XLC-WyldFyre/Robocup-Junior-2026/(list of files, cad)

Other CAD files:
PCBs/Bottom_PCB.f3z
PCBs/Top_PCB.f3z
