XLC-WyldFyre/Robocup-Junior-2026/PCBs/Top_PCB.brd

## EAGLE design PCBs/Top_PCB.brd (2026-08-17)

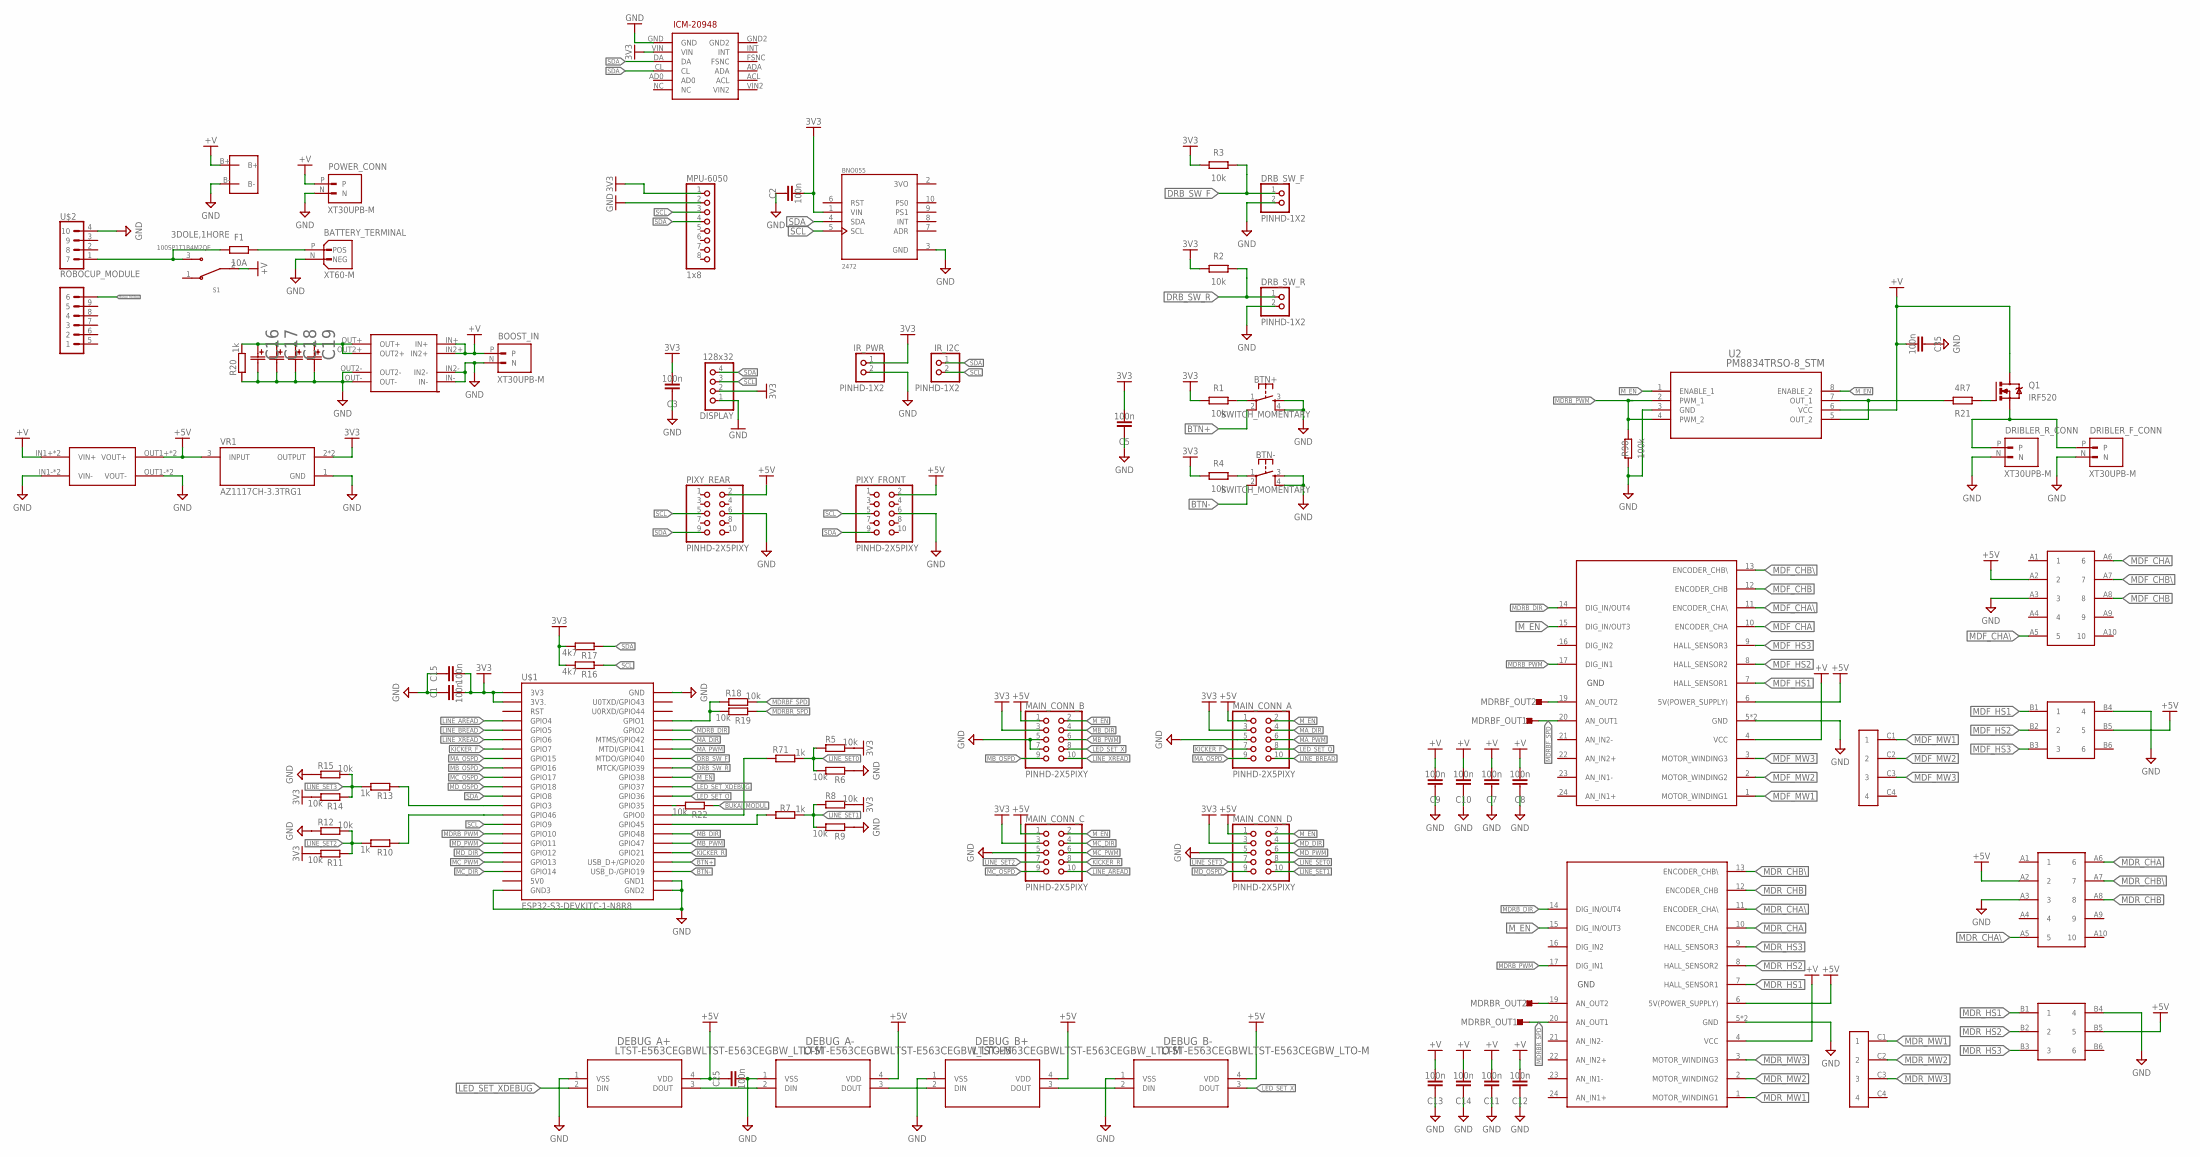
[picture p1: schematic Top_PCB.sch]

Parts:
BATTERY_TERMINAL: XT60-M; AMASS_XT60-M
BATT_VOLTAGE: BATT_V_METER; 1X02
BNO055: 2472; MODULE_2472
BOOST_IN: XT30UPB-M; AMASS_XT30UPB-M
BTN+: SWITCH_MOMENTARY; SWITCH-MOMENTARY-PTH-6.5MM
BTN-: SWITCH_MOMENTARY; SWITCH-MOMENTARY-PTH-6.5MM
C1, C2, C3, C5, C7, C8, C9, C10, C11, C12, C13, C14, C15, C25, C35: 100n; CAPC2012X110
C16, C17, C18, C19: 1mF; CAP_108CKE_ILC
DEBUG_A+: LTST-E563CEGBWLTST-E563CEGBW_LTO-M; LTST-E563CEGBW_LTO-M
DEBUG_A-: LTST-E563CEGBWLTST-E563CEGBW_LTO-M; LTST-E563CEGBW_LTO-M
DEBUG_B+: LTST-E563CEGBWLTST-E563CEGBW_LTO-M; LTST-E563CEGBW_LTO-M
DEBUG_B-: LTST-E563CEGBWLTST-E563CEGBW_LTO-M; LTST-E563CEGBW_LTO-M
DISPLAY: 128x32; 1X04
DRB_SW_F: PINHD-1X2; 1X02
DRB_SW_R: PINHD-1X2; 1X02
DRIBLER_F_CONN: XT30UPB-M; AMASS_XT30UPB-M
DRIBLER_R_CONN: XT30UPB-M; AMASS_XT30UPB-M
F1: 10A; RESC3216X70
ICM-20948: ICM-20948
IR_I2C: PINHD-1X2; 1X02
IR_PWR: PINHD-1X2; 1X02
MAIN_CONN_A: PINHD-2X5PIXY; 2X05
MAIN_CONN_B: PINHD-2X5PIXY; 2X05
MAIN_CONN_C: PINHD-2X5PIXY; 2X05
MAIN_CONN_D: PINHD-2X5PIXY; 2X05
MDRBF_OUT1, MDRBF_OUT2: TESTPOINT_TPS-PAD-036; TESTPOINT_PAD-036
MDRBR_OUT1, MDRBR_OUT2: TESTPOINT_TPS-PAD-036; TESTPOINT_PAD-036
MPU-6050: 1x8; 1X08
PIXY_FRONT: PINHD-2X5PIXY; 2X05
PIXY_REAR: PINHD-2X5PIXY; 2X05
POWER_CONN: XT30UPB-M; AMASS_XT30UPB-M
Q1: IRF520; TO220BV
R1, R2, R3, R4, R5, R6, R8, R9, R11, R12, R14, R15, R18, R19, R22: 10k; RESC2012X65
R7, R10, R13, R20, R71: 1k; RESC2012X65
R16, R17: 4k7; RESC2012X65
R21: 4R7; RESC2012X65
R98: 100k; RESC2012X65
S1: 100SP1T1B4M2QE; SW_100SP1T1B4M2QE
U2: PM8834TRSO-8_STM; SO-8_STM
U$1: ESP32-S3-DEVKITC-1-N8R8
U$2: ROBOCUP_MODULE
U$4: MP1584; DC-BRICK
U$5: BOOST
U$7, U$9: ESCON24/224/2; ESCON24/2
U$8, U$11: PIN2.54-2X5
U$10, U$12: MX-44914-0601
U$13, U$14: MX5566
VR1: AZ1117CH-3.3TRG1; VREG_AZ1117CH-3.3TRG1

Connections:
3DOLE,1HORE: F1.1, S1.3, U$2.1 (7)
3V3: BNO055.1 (VIN), C1.2, C2.2, C3.2, C5.2, C15.2, DISPLAY.2, ICM-20948.VIN, IR_PWR.1, MAIN_CONN_A.3, MAIN_CONN_B.3, MAIN_CONN_C.3, MAIN_CONN_D.3, MPU-6050.1, R1.1, R2.1, R3.1, R4.1, R5.1, R8.1, R11.1, R14.1, R16.1, R17.1, U$1.J1_1 (3V3), U$1.J1_2 (3V3.), VR1.2 (OUTPUT), VR1.4 (OUTPUT)
3VO: BNO055.2 (3VO)
5V0: U$1.J1_21 (5V0)
+5V: C25.1, DEBUG_A+.4 (VDD), DEBUG_A-.4 (VDD), DEBUG_B+.4 (VDD), DEBUG_B-.4 (VDD), MAIN_CONN_A.1, MAIN_CONN_B.1, MAIN_CONN_C.1, MAIN_CONN_D.1, PIXY_FRONT.2, PIXY_REAR.2, U$4.OUT1+ (VOUT+), U$4.OUT2+ (VOUT+), U$7.6 (5V(POWER_SUPPLY)), U$8.A2 (2), U$9.6 (5V(POWER_SUPPLY)), U$10.B5 (5), U$11.A2 (2), U$12.B5 (5), VR1.3 (INPUT)
+V: BATT_VOLTAGE.B+, BOOST_IN.P, C7.2, C8.2, C9.2, C10.2, C11.2, C12.2, C13.2, C14.2, C35.2, POWER_CONN.P, Q1.D, S1.2, U2.6 (VCC), U$4.IN1+ (VIN+), U$4.IN2+ (VIN+), U$5.IN2+, U$5.IN+, U$7.4 (VCC), U$9.4 (VCC)
BTN+: BTN+.2, U$1.J3_19 (USB_D+/GPIO20)
BTN-: BTN-.2, U$1.J3_20 (USB_D-/GPIO19)
BUKAJ_MODUL: R22.2, U$2.10 (6)
DRB_SW_F: DRB_SW_F.1, R3.2, U$1.J3_8 (MTDO/GPIO40)
DRB_SW_R: DRB_SW_R.1, R2.2, U$1.J3_9 (MTCK/GPIO39)
GND: BATTERY_TERMINAL.N (NEG), BATT_VOLTAGE.B-, BNO055.3 (GND), BOOST_IN.N, BTN+.3, BTN+.4, BTN-.3, BTN-.4, C1.1, C2.1, C3.1, C5.1, C7.1, C8.1, C9.1, C10.1, C11.1, C12.1, C13.1, C14.1, C15.1, C16.2, C17.2, C18.2, C19.2, C25.2, C35.1, DEBUG_A+.1 (VSS), DEBUG_A-.1 (VSS), DEBUG_B+.1 (VSS), DEBUG_B-.1 (VSS), DISPLAY.1, DRB_SW_F.2, DRB_SW_R.2, DRIBLER_F_CONN.N, DRIBLER_R_CONN.N, ICM-20948.GND, IR_PWR.2, MAIN_CONN_A.5, MAIN_CONN_B.5, MAIN_CONN_B.7, MAIN_CONN_C.5, MAIN_CONN_D.5, MPU-6050.2, PIXY_FRONT.6, PIXY_REAR.6, POWER_CONN.N, R6.2, R9.2, R12.2, R15.2, R20.2, R98.1, U2.3 (GND), U$1.J1_22 (GND3), U$1.J3_1 (GND), U$1.J3_21 (GND1), U$1.J3_22 (GND2), U$2.4 (10), U$4.IN1- (VIN-), U$4.IN2- (VIN-), U$4.OUT1- (VOUT-), U$4.OUT2- (VOUT-), U$5.IN2-, U$5.IN-, U$5.OUT2-, U$5.OUT-, U$7.5 (GND), U$7.18 (GND), U$8.A3 (3), U$9.5 (GND), U$9.18 (GND), U$10.B4 (4), U$11.A3 (3), U$12.B4 (4), VR1.1 (GND)
KICKER_F: MAIN_CONN_A.7, U$1.J1_7 (GPIO7)
KICKER_R: MAIN_CONN_C.8, U$1.J3_18 (GPIO21)
LED_SET_DEBUG1: DEBUG_A-.3 (DOUT), DEBUG_B+.2 (DIN)
LED_SET_O: MAIN_CONN_A.8, U$1.J3_12 (GPIO36)
LED_SET_X: DEBUG_B-.3 (DOUT), MAIN_CONN_B.8
LED_SET_XDEBUG: DEBUG_A+.2 (DIN), U$1.J3_11 (GPIO37)
LINE_AREAD: MAIN_CONN_C.10, U$1.J1_4 (GPIO4)
LINE_BREAD: MAIN_CONN_A.10, U$1.J1_5 (GPIO5)
LINE_SET0: MAIN_CONN_D.8, R5.2, R6.1, R71.1
LINE_SET1: MAIN_CONN_D.10, R7.1, R8.2, R9.1
LINE_SET2: MAIN_CONN_C.7, R10.1, R11.2, R12.1
LINE_SET3: MAIN_CONN_D.7, R13.1, R14.2, R15.1
LINE_XREAD: MAIN_CONN_B.10, U$1.J1_6 (GPIO6)
MA_DIR: MAIN_CONN_A.4, U$1.J3_6 (MTMS/GPIO42)
MA_OSPD: MAIN_CONN_A.9, U$1.J1_8 (GPIO15)
MA_PWM: MAIN_CONN_A.6, U$1.J3_7 (MTDI/GPIO41)
MB_DIR: MAIN_CONN_B.4, U$1.J3_16 (GPIO48)
MB_OSPD: MAIN_CONN_B.9, U$1.J1_9 (GPIO16)
MB_PWM: MAIN_CONN_B.6, U$1.J3_17 (GPIO47)
MC_DIR: MAIN_CONN_C.4, U$1.J1_20 (GPIO14)
MC_OSPD: MAIN_CONN_C.9, U$1.J1_10 (GPIO17)
MC_PWM: MAIN_CONN_C.6, U$1.J1_19 (GPIO13)
MDF_CHA: U$9.10 (ENCODER_CHA), U$11.A6 (6)
MDF_CHA\\: U$9.11 (ENCODER_CHA\\), U$11.A5 (5)
MDF_CHB: U$9.12 (ENCODER_CHB), U$11.A8 (8)
MDF_CHB\\: U$9.13 (ENCODER_CHB\\), U$11.A7 (7)
MDF_HS1: U$9.7 (HALL_SENSOR1), U$12.B1 (1)
MDF_HS2: U$9.8 (HALL_SENSOR2), U$12.B2 (2)
MDF_HS3: U$9.9 (HALL_SENSOR3), U$12.B3 (3)
MDF_MW1: U$9.1 (MOTOR_WINDING1), U$13.C1 (1)
MDF_MW2: U$9.2 (MOTOR_WINDING2), U$13.C2 (2)
MDF_MW3: U$9.3 (MOTOR_WINDING3), U$13.C3 (3)
MDRBF_SPD: MDRBF_OUT1.1, R18.1, U$9.20 (AN_OUT1)
MDRBR_SPD: MDRBR_OUT1.1, R19.2, U$7.20 (AN_OUT1)
MDRB_DIR: U$1.J3_5 (GPIO2), U$7.14 (DIG_IN/OUT4), U$9.14 (DIG_IN/OUT4)
MDRB_PWM: R98.2, U2.2 (PWM_1), U2.4 (PWM_2), U$1.J1_16 (GPIO10), U$7.17 (DIG_IN1), U$9.17 (DIG_IN1)
MDRB_SPD: R18.2, R19.1, U$1.J3_4 (GPIO1)
MDR_CHA: U$7.10 (ENCODER_CHA), U$8.A6 (6)
MDR_CHA\\: U$7.11 (ENCODER_CHA\\), U$8.A5 (5)
MDR_CHB: U$7.12 (ENCODER_CHB), U$8.A8 (8)
MDR_CHB\\: U$7.13 (ENCODER_CHB\\), U$8.A7 (7)
MDR_HS1: U$7.7 (HALL_SENSOR1), U$10.B1 (1)
MDR_HS2: U$7.8 (HALL_SENSOR2), U$10.B2 (2)
MDR_HS3: U$7.9 (HALL_SENSOR3), U$10.B3 (3)
MDR_MW1: U$7.1 (MOTOR_WINDING1), U$14.C1 (1)
MDR_MW2: U$7.2 (MOTOR_WINDING2), U$14.C2 (2)
MDR_MW3: U$7.3 (MOTOR_WINDING3), U$14.C3 (3)
MD_DIR: MAIN_CONN_D.4, U$1.J1_18 (GPIO12)
MD_OSPD: MAIN_CONN_D.9, U$1.J1_11 (GPIO18)
MD_PWM: MAIN_CONN_D.6, U$1.J1_17 (GPIO11)
M_EN: MAIN_CONN_A.2, MAIN_CONN_B.2, MAIN_CONN_C.2, MAIN_CONN_D.2, U2.1 (ENABLE_1), U2.8 (ENABLE_2), U$1.J3_10 (GPIO38), U$7.15 (DIG_IN/OUT3), U$9.15 (DIG_IN/OUT3)
unnamed: DEBUG_B+.3 (DOUT), DEBUG_B-.2 (DIN)
unnamed: C16.1, C17.1, C18.1, C19.1, R20.1, U$5.OUT2+, U$5.OUT+
unnamed: BATTERY_TERMINAL.P (POS), F1.2
unnamed: Q1.G, R21.1
unnamed: R22.1, U$1.J3_13 (GPIO35)
unnamed: BTN+.1, R1.2
unnamed: MDRBR_OUT2.1, U$7.19 (AN_OUT2)
unnamed: BTN-.1, R4.2
unnamed: R13.2, U$1.J1_13 (GPIO3)
unnamed: R71.2, U$1.J3_14 (GPIO0)
unnamed: DEBUG_A+.3 (DOUT), DEBUG_A-.2 (DIN)
unnamed: DRIBLER_F_CONN.P, DRIBLER_R_CONN.P, Q1.S
unnamed: R10.2, U$1.J1_14 (GPIO46)
unnamed: R7.2, U$1.J3_15 (GPIO45)
unnamed: R21.2, U2.5 (OUT_2), U2.7 (OUT_1)
unnamed: MDRBF_OUT2.1, U$9.19 (AN_OUT2)
SCL: BNO055.5 (SCL), DISPLAY.3, IR_I2C.2, MPU-6050.3, PIXY_FRONT.5, PIXY_REAR.5, R16.2, U$1.J1_15 (GPIO9)
SDA: BNO055.4 (SDA), DISPLAY.4, ICM-20948.CL, ICM-20948.DA, IR_I2C.1, MPU-6050.4, PIXY_FRONT.9, PIXY_REAR.9, R17.2, U$1.J1_12 (GPIO8)

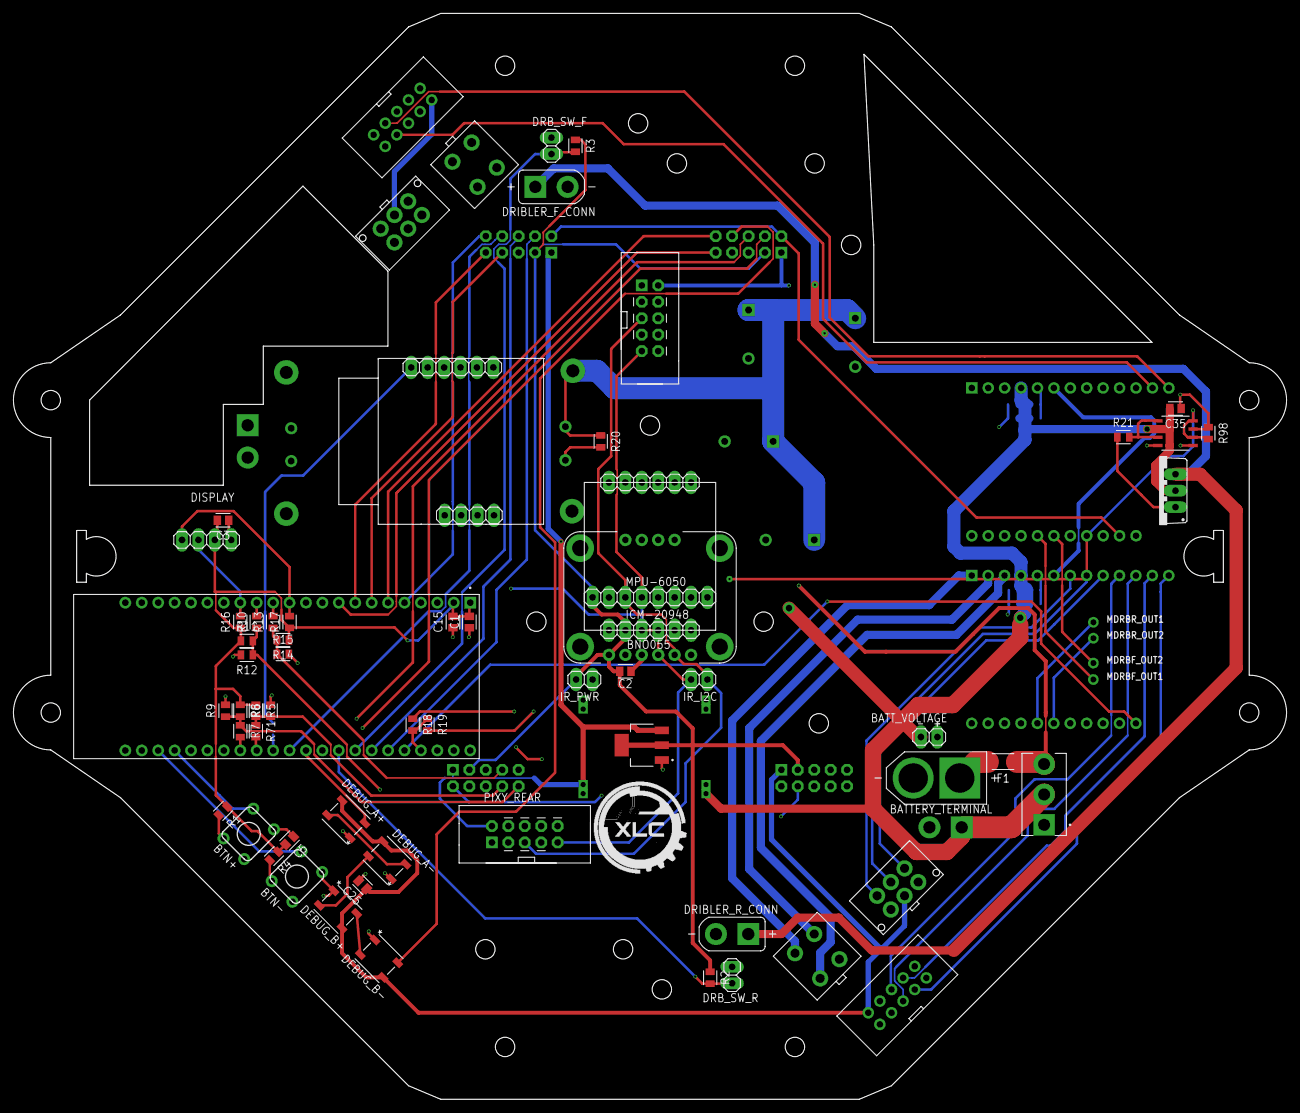
[picture p2: board Top_PCB.brd from above]

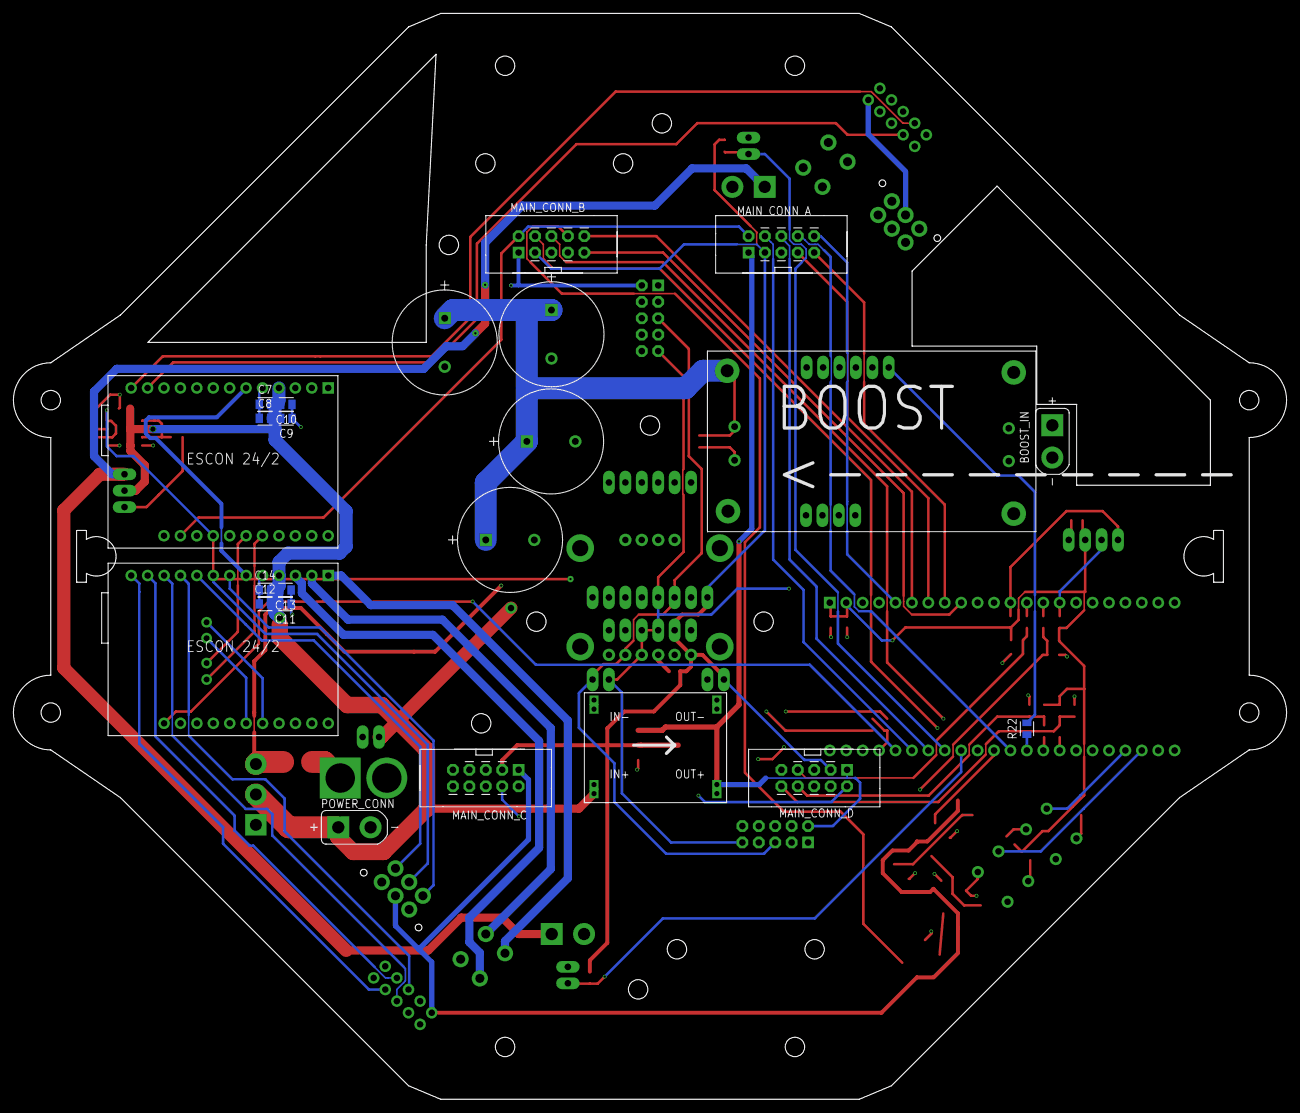
[picture p3: board Top_PCB.brd from below]

Board: 4 copper layers, 196.9 x 168.0 mm, 90 parts (23 on the bottom side), 79 nets.
