XLC-WyldFyre/Robocup-Junior-2026/PCBs/Bottom_PCB.brd

## EAGLE design PCBs/Bottom_PCB.brd (2026-08-17)

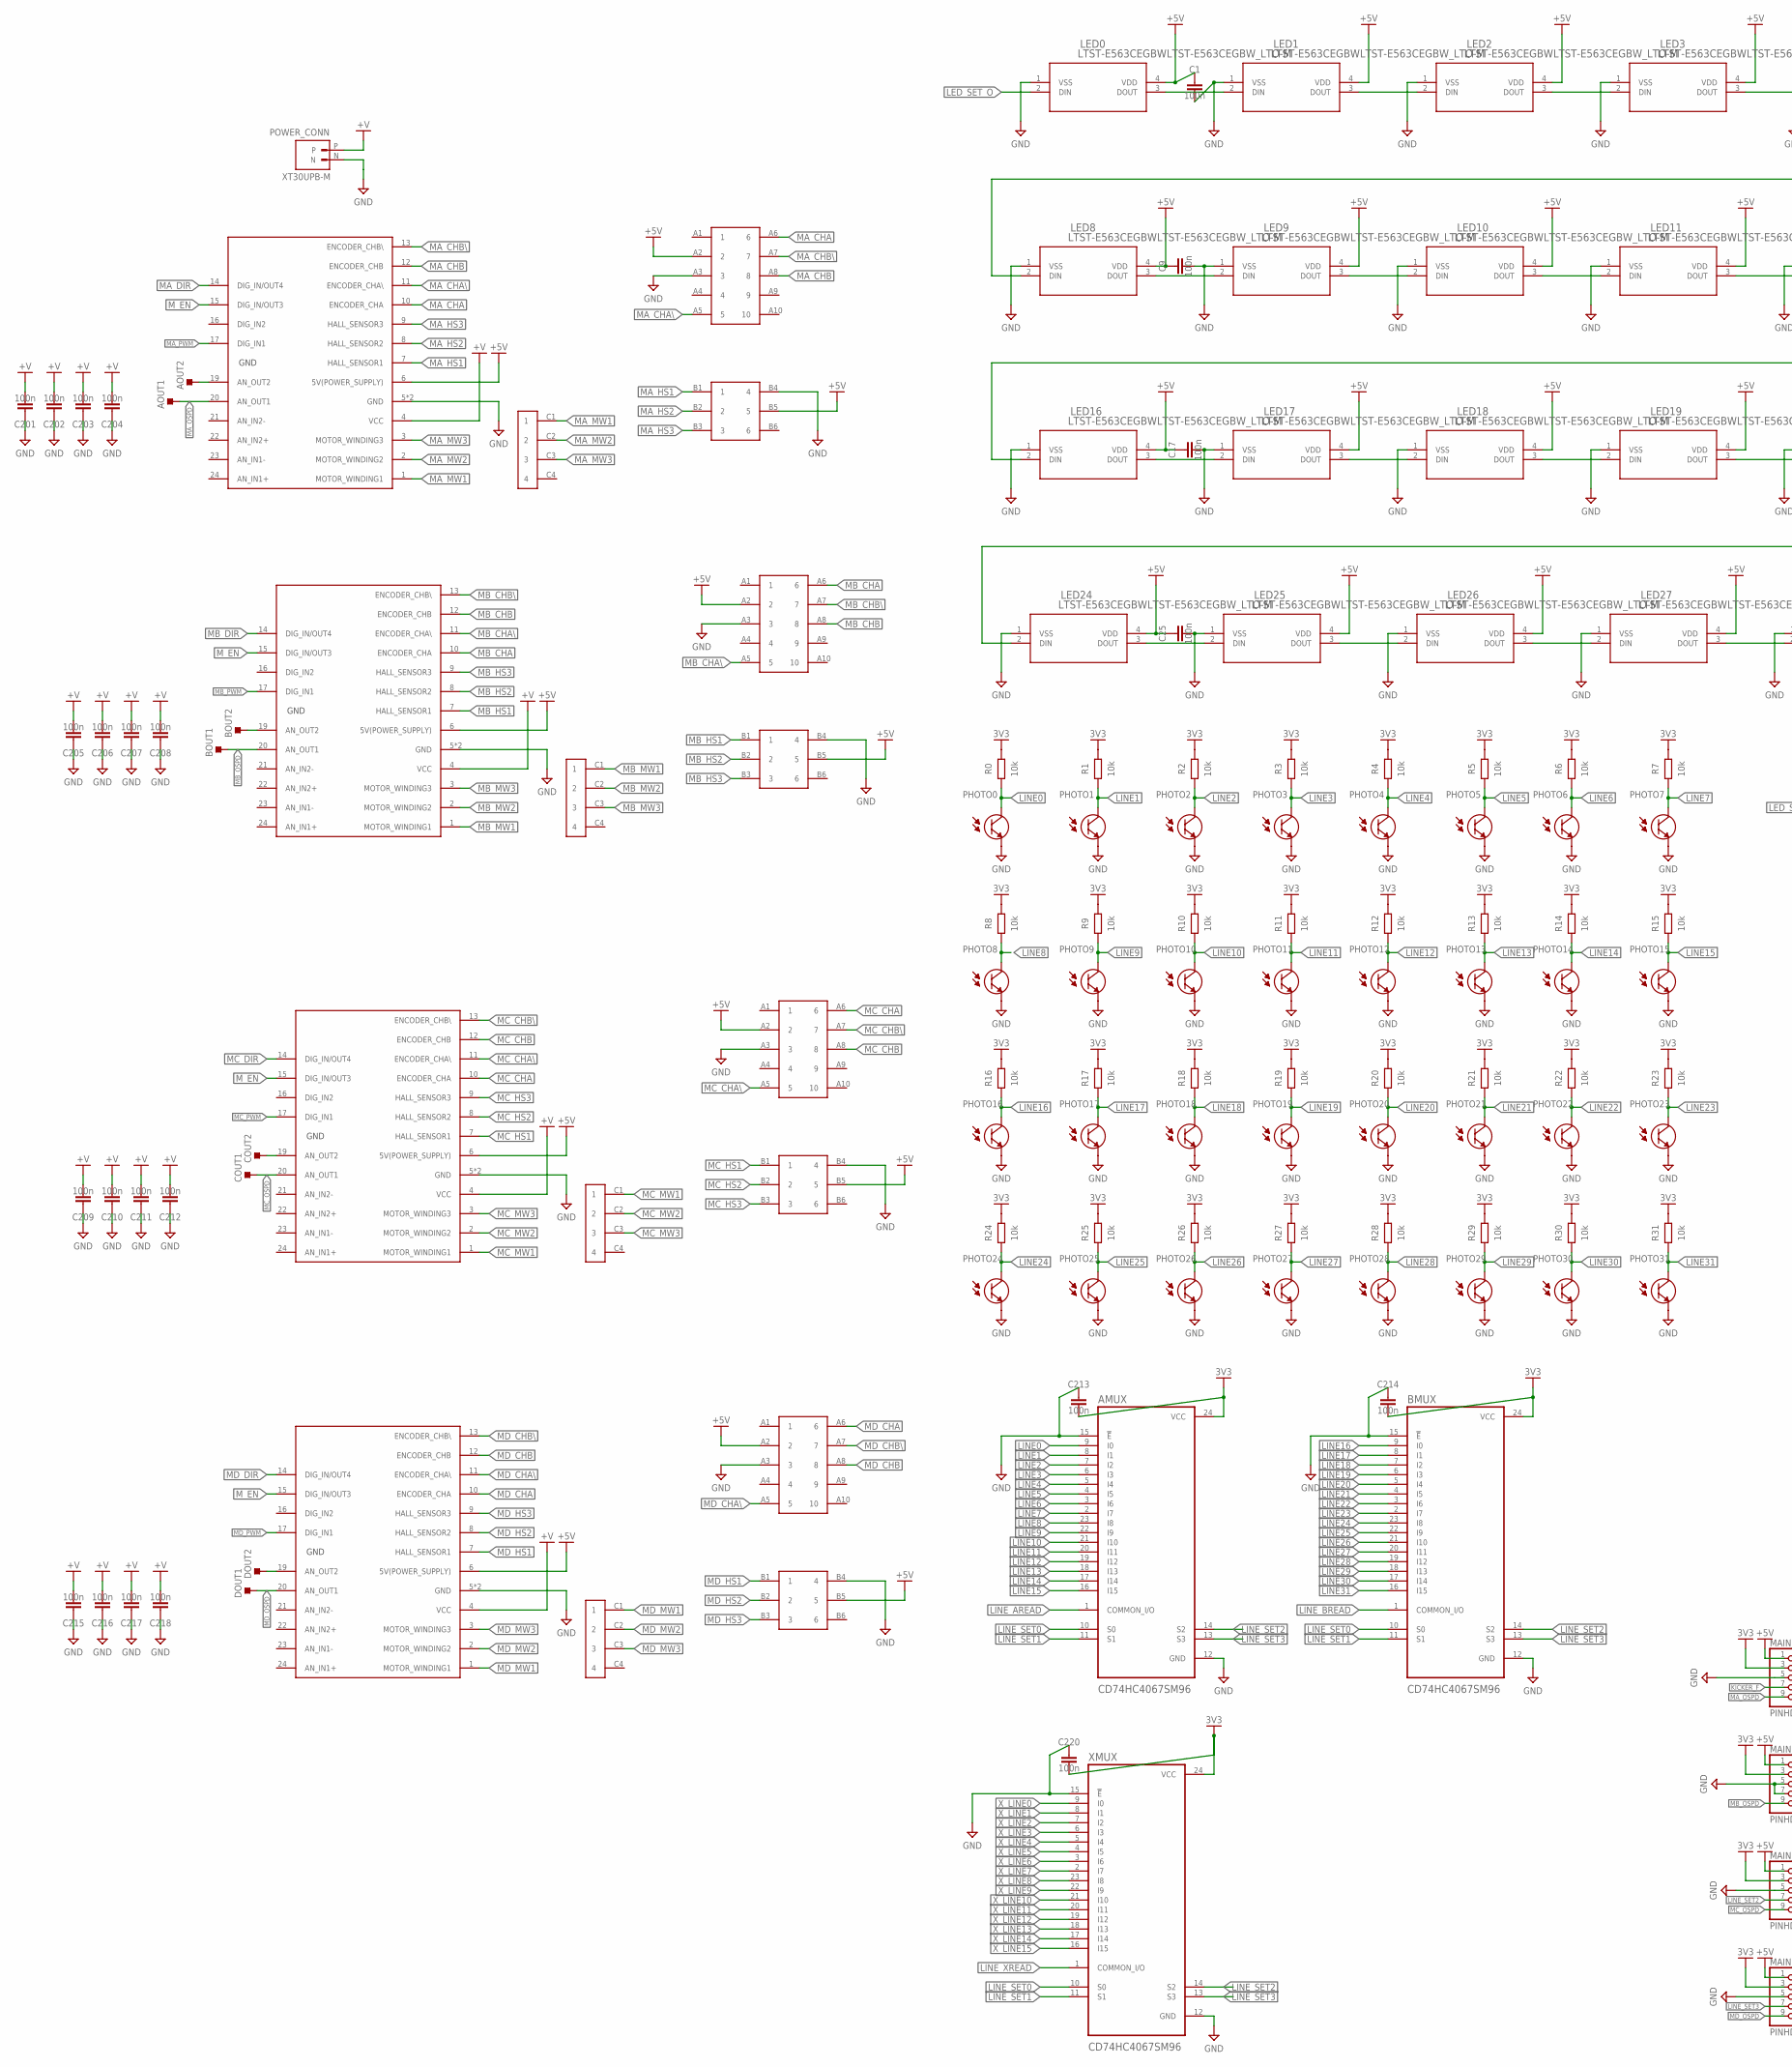
[picture p4: schematic Bottom_PCB.sch, part in row 1, column 1]

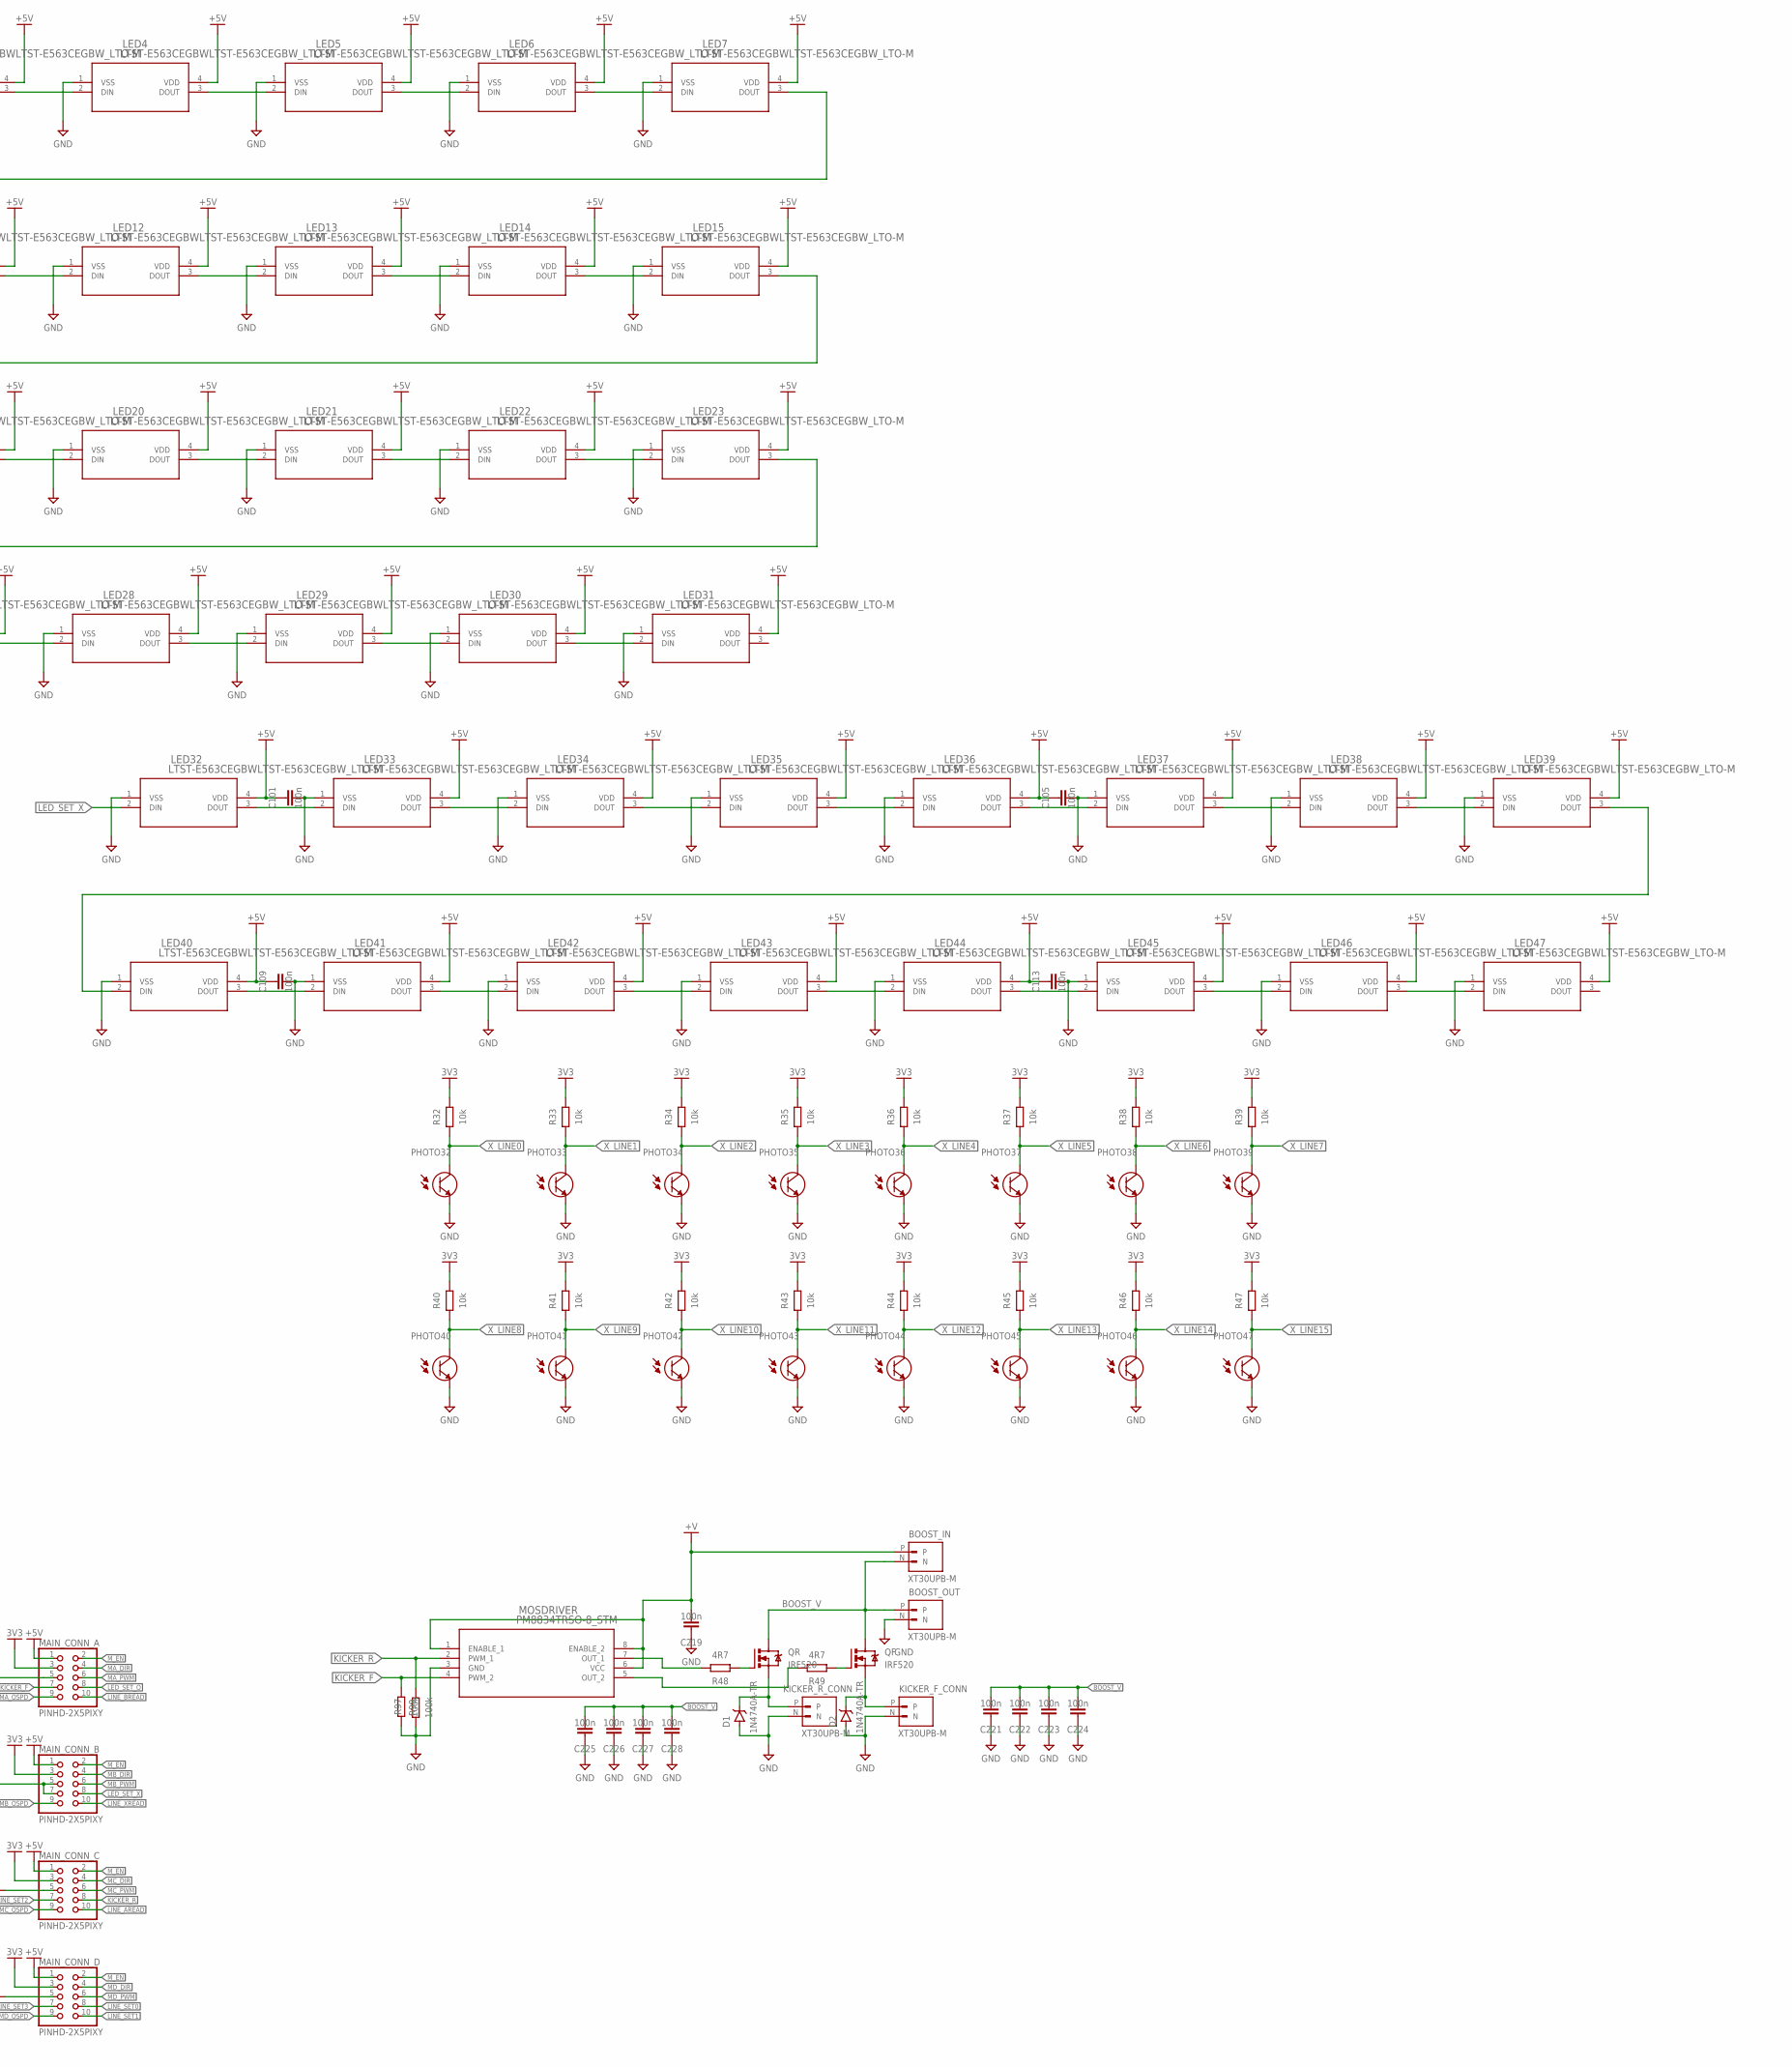
[picture p5: schematic Bottom_PCB.sch, part in row 1, column 2]

Parts:
AENC: PIN2.54-2X5
AHAL: MX-44914-0601
AMD: ESCON24/224/2; ESCON24/2
AMUX: CD74HC4067SM96; SOP65P780X200-24N
AMW: MX5566
AOUT1, AOUT2: TESTPOINT_TPS-PAD-036; TESTPOINT_PAD-036
BENC: PIN2.54-2X5
BHAL: MX-44914-0601
BMD: ESCON24/224/2; ESCON24/2
BMUX: CD74HC4067SM96; SOP65P780X200-24N
BMW: MX5566
BOOST_IN: XT30UPB-M; AMASS_XT30UPB-M
BOOST_OUT: XT30UPB-M; AMASS_XT30UPB-M
BOUT1, BOUT2: TESTPOINT_TPS-PAD-036; TESTPOINT_PAD-036
C1, C9, C17, C25, C101, C105, C109, C113, C201, C202, C203, C204, C205, C206, C207, C208, C209, C210, C211, C212, C213, C214, C215, C216, C217, C218, C219, C220, C221, C222, C223, C224, C225, C226, C227, C228: 100n; CAPC2012X110
CENC: PIN2.54-2X5
CHAL: MX-44914-0601
CMD: ESCON24/224/2; ESCON24/2
CMW: MX5566
COUT1, COUT2: TESTPOINT_TPS-PAD-036; TESTPOINT_PAD-036
D1, D2: 1N4740A-TR; DO-41
DENC: PIN2.54-2X5
DHAL: MX-44914-0601
DMD: ESCON24/224/2; ESCON24/2
DMW: MX5566
DOUT1, DOUT2: TESTPOINT_TPS-PAD-036; TESTPOINT_PAD-036
KICKER_F_CONN: XT30UPB-M; AMASS_XT30UPB-M
KICKER_R_CONN: XT30UPB-M; AMASS_XT30UPB-M
LED0, LED1, LED2, LED3, LED4, LED5, LED6, LED7, LED8, LED9, LED10, LED11, LED12, LED13, LED14, LED15, LED16, LED17, LED18, LED19, LED20, LED21, LED22, LED23, LED24, LED25, LED26, LED27, LED28, LED29, LED30, LED31, LED32, LED33, LED34, LED35, LED36, LED37, LED38, LED39, LED40, LED41, LED42, LED43, LED44, LED45, LED46, LED47: LTST-E563CEGBWLTST-E563CEGBW_LTO-M; LTST-E563CEGBW_LTO-M
MAIN_CONN_A: PINHD-2X5PIXY; 2X05
MAIN_CONN_B: PINHD-2X5PIXY; 2X05
MAIN_CONN_C: PINHD-2X5PIXY; 2X05
MAIN_CONN_D: PINHD-2X5PIXY; 2X05
MOSDRIVER: PM8834TRSO-8_STM; SO-8_STM
PHOTO0, PHOTO1, PHOTO2, PHOTO3, PHOTO4, PHOTO5, PHOTO6, PHOTO7, PHOTO8, PHOTO9, PHOTO10, PHOTO11, PHOTO12, PHOTO13, PHOTO14, PHOTO15, PHOTO16, PHOTO17, PHOTO18, PHOTO19, PHOTO20, PHOTO21, PHOTO22, PHOTO23, PHOTO24, PHOTO25, PHOTO26, PHOTO27, PHOTO28, PHOTO29, PHOTO30, PHOTO31, PHOTO32, PHOTO33, PHOTO34, PHOTO35, PHOTO36, PHOTO37, PHOTO38, PHOTO39, PHOTO40, PHOTO41, PHOTO42, PHOTO43, PHOTO44, PHOTO45, PHOTO46, PHOTO47: RPM-075PTT86TRANS_RPM-075P_ROM; TRANS_RPM-075P_ROM
POWER_CONN: XT30UPB-M; AMASS_XT30UPB-M
QF: IRF520; TO220BV
QR: IRF520; TO220BV
R0, R1, R2, R3, R4, R5, R6, R7, R8, R9, R10, R11, R12, R13, R14, R15, R16, R17, R18, R19, R20, R21, R22, R23, R24, R25, R26, R27, R28, R29, R30, R31, R32, R33, R34, R35, R36, R37, R38, R39, R40, R41, R42, R43, R44, R45, R46, R47: 10k; RESC2012X65
R48, R49: 4R7; RESC2012X65
R97, R98: 100k; RESC2012X65
XMUX: CD74HC4067SM96; SOP65P780X200-24N

Connections:
3V3: AMUX.24 (VCC), BMUX.24 (VCC), C213.2, C214.2, C220.2, MAIN_CONN_A.3, MAIN_CONN_B.3, MAIN_CONN_C.3, MAIN_CONN_D.3, R0.2, R1.2, R2.2, R3.2, R4.2, R5.2, R6.2, R7.2, R8.2, R9.2, R10.2, R11.2, R12.2, R13.2, R14.2, R15.2, R16.2, R17.2, R18.2, R19.2, R20.2, R21.2, R22.2, R23.2, R24.2, R25.2, R26.2, R27.2, R28.2, R29.2, R30.2, R31.2, R32.2, R33.2, R34.2, R35.2, R36.2, R37.2, R38.2, R39.2, R40.2, R41.2, R42.2, R43.2, R44.2, R45.2, R46.2, R47.2, XMUX.24 (VCC)
+5V: AENC.A2 (2), AHAL.B5 (5), AMD.6 (5V(POWER_SUPPLY)), BENC.A2 (2), BHAL.B5 (5), BMD.6 (5V(POWER_SUPPLY)), C1.1, C9.1, C17.1, C25.1, C101.1, C105.1, C109.1, C113.1, CENC.A2 (2), CHAL.B5 (5), CMD.6 (5V(POWER_SUPPLY)), DENC.A2 (2), DHAL.B5 (5), DMD.6 (5V(POWER_SUPPLY)), LED0.4 (VDD), LED1.4 (VDD), LED2.4 (VDD), LED3.4 (VDD), LED4.4 (VDD), LED5.4 (VDD), LED6.4 (VDD), LED7.4 (VDD), LED8.4 (VDD), LED9.4 (VDD), LED10.4 (VDD), LED11.4 (VDD), LED12.4 (VDD), LED13.4 (VDD), LED14.4 (VDD), LED15.4 (VDD), LED16.4 (VDD), LED17.4 (VDD), LED18.4 (VDD), LED19.4 (VDD), LED20.4 (VDD), LED21.4 (VDD), LED22.4 (VDD), LED23.4 (VDD), LED24.4 (VDD), LED25.4 (VDD), LED26.4 (VDD), LED27.4 (VDD), LED28.4 (VDD), LED29.4 (VDD), LED30.4 (VDD), LED31.4 (VDD), LED32.4 (VDD), LED33.4 (VDD), LED34.4 (VDD), LED35.4 (VDD), LED36.4 (VDD), LED37.4 (VDD), LED38.4 (VDD), LED39.4 (VDD), LED40.4 (VDD), LED41.4 (VDD), LED42.4 (VDD), LED43.4 (VDD), LED44.4 (VDD), LED45.4 (VDD), LED46.4 (VDD), LED47.4 (VDD), MAIN_CONN_A.1, MAIN_CONN_B.1, MAIN_CONN_C.1, MAIN_CONN_D.1
+V: AMD.4 (VCC), BMD.4 (VCC), BOOST_IN.P, C201.2, C202.2, C203.2, C204.2, C205.2, C206.2, C207.2, C208.2, C209.2, C210.2, C211.2, C212.2, C215.2, C216.2, C217.2, C218.2, C219.2, CMD.4 (VCC), DMD.4 (VCC), MOSDRIVER.1 (ENABLE_1), MOSDRIVER.6 (VCC), MOSDRIVER.8 (ENABLE_2), POWER_CONN.P
BOOST_V: BOOST_IN.N, BOOST_OUT.P, C221.2, C222.2, C223.2, C224.2, C225.2, C226.2, C227.2, C228.2, QF.D, QR.D
GND: AENC.A3 (3), AHAL.B4 (4), AMD.5 (GND), AMD.18 (GND), AMUX.12 (GND), AMUX.15 (!E), BENC.A3 (3), BHAL.B4 (4), BMD.5 (GND), BMD.18 (GND), BMUX.12 (GND), BMUX.15 (!E), BOOST_OUT.N, C1.2, C9.2, C17.2, C25.2, C101.2, C105.2, C109.2, C113.2, C201.1, C202.1, C203.1, C204.1, C205.1, C206.1, C207.1, C208.1, C209.1, C210.1, C211.1, C212.1, C213.1, C214.1, C215.1, C216.1, C217.1, C218.1, C219.1, C220.1, C221.1, C222.1, C223.1, C224.1, C225.1, C226.1, C227.1, C228.1, CENC.A3 (3), CHAL.B4 (4), CMD.5 (GND), CMD.18 (GND), D1.A, D2.A, DENC.A3 (3), DHAL.B4 (4), DMD.5 (GND), DMD.18 (GND), KICKER_F_CONN.N, KICKER_R_CONN.N, LED0.1 (VSS), LED1.1 (VSS), LED2.1 (VSS), LED3.1 (VSS), LED4.1 (VSS), LED5.1 (VSS), LED6.1 (VSS), LED7.1 (VSS), LED8.1 (VSS), LED9.1 (VSS), LED10.1 (VSS), LED11.1 (VSS), LED12.1 (VSS), LED13.1 (VSS), LED14.1 (VSS), LED15.1 (VSS), LED16.1 (VSS), LED17.1 (VSS), LED18.1 (VSS), LED19.1 (VSS), LED20.1 (VSS), LED21.1 (VSS), LED22.1 (VSS), LED23.1 (VSS), LED24.1 (VSS), LED25.1 (VSS), LED26.1 (VSS), LED27.1 (VSS), LED28.1 (VSS), LED29.1 (VSS), LED30.1 (VSS), LED31.1 (VSS), LED32.1 (VSS), LED33.1 (VSS), LED34.1 (VSS), LED35.1 (VSS), LED36.1 (VSS), LED37.1 (VSS), LED38.1 (VSS), LED39.1 (VSS), LED40.1 (VSS), LED41.1 (VSS), LED42.1 (VSS), LED43.1 (VSS), LED44.1 (VSS), LED45.1 (VSS), LED46.1 (VSS), LED47.1 (VSS), MAIN_CONN_A.5, MAIN_CONN_B.5, MAIN_CONN_B.7, MAIN_CONN_C.5, MAIN_CONN_D.5, MOSDRIVER.3 (GND), PHOTO0.1, PHOTO1.1, PHOTO2.1, PHOTO3.1, PHOTO4.1, PHOTO5.1, PHOTO6.1, PHOTO7.1, PHOTO8.1, PHOTO9.1, PHOTO10.1, PHOTO11.1, PHOTO12.1, PHOTO13.1, PHOTO14.1, PHOTO15.1, PHOTO16.1, PHOTO17.1, PHOTO18.1, PHOTO19.1, PHOTO20.1, PHOTO21.1, PHOTO22.1, PHOTO23.1, PHOTO24.1, PHOTO25.1, PHOTO26.1, PHOTO27.1, PHOTO28.1, PHOTO29.1, PHOTO30.1, PHOTO31.1, PHOTO32.1, PHOTO33.1, PHOTO34.1, PHOTO35.1, PHOTO36.1, PHOTO37.1, PHOTO38.1, PHOTO39.1, PHOTO40.1, PHOTO41.1, PHOTO42.1, PHOTO43.1, PHOTO44.1, PHOTO45.1, PHOTO46.1, PHOTO47.1, POWER_CONN.N, R97.1, R98.1, XMUX.12 (GND), XMUX.15 (!E)
KICKER_F: MAIN_CONN_A.7, MOSDRIVER.4 (PWM_2), R97.2
KICKER_R: MAIN_CONN_C.8, MOSDRIVER.2 (PWM_1), R98.2
LED_SET_O: LED0.2 (DIN), MAIN_CONN_A.8
LED_SET_X: LED32.2 (DIN), MAIN_CONN_B.8
LINE0: AMUX.9 (I0), PHOTO0.2, R0.1
LINE1: AMUX.8 (I1), PHOTO1.2, R1.1
LINE2: AMUX.7 (I2), PHOTO2.2, R2.1
LINE3: AMUX.6 (I3), PHOTO3.2, R3.1
LINE4: AMUX.5 (I4), PHOTO4.2, R4.1
LINE5: AMUX.4 (I5), PHOTO5.2, R5.1
LINE6: AMUX.3 (I6), PHOTO6.2, R6.1
LINE7: AMUX.2 (I7), PHOTO7.2, R7.1
LINE8: AMUX.23 (I8), PHOTO8.2, R8.1
LINE9: AMUX.22 (I9), PHOTO9.2, R9.1
LINE10: AMUX.21 (I10), PHOTO10.2, R10.1
LINE11: AMUX.20 (I11), PHOTO11.2, R11.1
LINE12: AMUX.19 (I12), PHOTO12.2, R12.1
LINE13: AMUX.18 (I13), PHOTO13.2, R13.1
LINE14: AMUX.17 (I14), PHOTO14.2, R14.1
LINE15: AMUX.16 (I15), PHOTO15.2, R15.1
LINE16: BMUX.9 (I0), PHOTO16.2, R16.1
LINE17: BMUX.8 (I1), PHOTO17.2, R17.1
LINE18: BMUX.7 (I2), PHOTO18.2, R18.1
LINE19: BMUX.6 (I3), PHOTO19.2, R19.1
LINE20: BMUX.5 (I4), PHOTO20.2, R20.1
LINE21: BMUX.4 (I5), PHOTO21.2, R21.1
LINE22: BMUX.3 (I6), PHOTO22.2, R22.1
LINE23: BMUX.2 (I7), PHOTO23.2, R23.1
LINE24: BMUX.23 (I8), PHOTO24.2, R24.1
LINE25: BMUX.22 (I9), PHOTO25.2, R25.1
LINE26: BMUX.21 (I10), PHOTO26.2, R26.1
LINE27: BMUX.20 (I11), PHOTO27.2, R27.1
LINE28: BMUX.19 (I12), PHOTO28.2, R28.1
LINE29: BMUX.18 (I13), PHOTO29.2, R29.1
LINE30: BMUX.17 (I14), PHOTO30.2, R30.1
LINE31: BMUX.16 (I15), PHOTO31.2, R31.1
LINE_AREAD: AMUX.1 (COMMON_I/O), MAIN_CONN_C.10
LINE_BREAD: BMUX.1 (COMMON_I/O), MAIN_CONN_A.10
LINE_SET0: AMUX.10 (S0), BMUX.10 (S0), MAIN_CONN_D.8, XMUX.10 (S0)
LINE_SET1: AMUX.11 (S1), BMUX.11 (S1), MAIN_CONN_D.10, XMUX.11 (S1)
LINE_SET2: AMUX.14 (S2), BMUX.14 (S2), MAIN_CONN_C.7, XMUX.14 (S2)
LINE_SET3: AMUX.13 (S3), BMUX.13 (S3), MAIN_CONN_D.7, XMUX.13 (S3)
LINE_XREAD: MAIN_CONN_B.10, XMUX.1 (COMMON_I/O)
MA_CHA: AENC.A6 (6), AMD.10 (ENCODER_CHA)
MA_CHA\\: AENC.A5 (5), AMD.11 (ENCODER_CHA\\)
MA_CHB: AENC.A8 (8), AMD.12 (ENCODER_CHB)
MA_CHB\\: AENC.A7 (7), AMD.13 (ENCODER_CHB\\)
MA_DIR: AMD.14 (DIG_IN/OUT4), MAIN_CONN_A.4
MA_HS1: AHAL.B1 (1), AMD.7 (HALL_SENSOR1)
MA_HS2: AHAL.B2 (2), AMD.8 (HALL_SENSOR2)
MA_HS3: AHAL.B3 (3), AMD.9 (HALL_SENSOR3)
MA_MW1: AMD.1 (MOTOR_WINDING1), AMW.C1 (1)
MA_MW2: AMD.2 (MOTOR_WINDING2), AMW.C2 (2)
MA_MW3: AMD.3 (MOTOR_WINDING3), AMW.C3 (3)
MA_OSPD: AMD.20 (AN_OUT1), AOUT1.1, MAIN_CONN_A.9
MA_PWM: AMD.17 (DIG_IN1), MAIN_CONN_A.6
MB_CHA: BENC.A6 (6), BMD.10 (ENCODER_CHA)
MB_CHA\\: BENC.A5 (5), BMD.11 (ENCODER_CHA\\)
MB_CHB: BENC.A8 (8), BMD.12 (ENCODER_CHB)
MB_CHB\\: BENC.A7 (7), BMD.13 (ENCODER_CHB\\)
MB_DIR: BMD.14 (DIG_IN/OUT4), MAIN_CONN_B.4
MB_HS1: BHAL.B1 (1), BMD.7 (HALL_SENSOR1)
MB_HS2: BHAL.B2 (2), BMD.8 (HALL_SENSOR2)
MB_HS3: BHAL.B3 (3), BMD.9 (HALL_SENSOR3)
MB_MW1: BMD.1 (MOTOR_WINDING1), BMW.C1 (1)
MB_MW2: BMD.2 (MOTOR_WINDING2), BMW.C2 (2)
MB_MW3: BMD.3 (MOTOR_WINDING3), BMW.C3 (3)
MB_OSPD: BMD.20 (AN_OUT1), BOUT1.1, MAIN_CONN_B.9
MB_PWM: BMD.17 (DIG_IN1), MAIN_CONN_B.6
MC_CHA: CENC.A6 (6), CMD.10 (ENCODER_CHA)
MC_CHA\\: CENC.A5 (5), CMD.11 (ENCODER_CHA\\)
MC_CHB: CENC.A8 (8), CMD.12 (ENCODER_CHB)
MC_CHB\\: CENC.A7 (7), CMD.13 (ENCODER_CHB\\)
MC_DIR: CMD.14 (DIG_IN/OUT4), MAIN_CONN_C.4
MC_HS1: CHAL.B1 (1), CMD.7 (HALL_SENSOR1)
MC_HS2: CHAL.B2 (2), CMD.8 (HALL_SENSOR2)
MC_HS3: CHAL.B3 (3), CMD.9 (HALL_SENSOR3)
MC_MW1: CMD.1 (MOTOR_WINDING1), CMW.C1 (1)
MC_MW2: CMD.2 (MOTOR_WINDING2), CMW.C2 (2)
MC_MW3: CMD.3 (MOTOR_WINDING3), CMW.C3 (3)
MC_OSPD: CMD.20 (AN_OUT1), COUT1.1, MAIN_CONN_C.9
MC_PWM: CMD.17 (DIG_IN1), MAIN_CONN_C.6
MD_CHA: DENC.A6 (6), DMD.10 (ENCODER_CHA)
MD_CHA\\: DENC.A5 (5), DMD.11 (ENCODER_CHA\\)
MD_CHB: DENC.A8 (8), DMD.12 (ENCODER_CHB)
MD_CHB\\: DENC.A7 (7), DMD.13 (ENCODER_CHB\\)
MD_DIR: DMD.14 (DIG_IN/OUT4), MAIN_CONN_D.4
MD_HS1: DHAL.B1 (1), DMD.7 (HALL_SENSOR1)
MD_HS2: DHAL.B2 (2), DMD.8 (HALL_SENSOR2)
MD_HS3: DHAL.B3 (3), DMD.9 (HALL_SENSOR3)
MD_MW1: DMD.1 (MOTOR_WINDING1), DMW.C1 (1)
MD_MW2: DMD.2 (MOTOR_WINDING2), DMW.C2 (2)
MD_MW3: DMD.3 (MOTOR_WINDING3), DMW.C3 (3)
MD_OSPD: DMD.20 (AN_OUT1), DOUT1.1, MAIN_CONN_D.9
MD_PWM: DMD.17 (DIG_IN1), MAIN_CONN_D.6
M_EN: AMD.15 (DIG_IN/OUT3), BMD.15 (DIG_IN/OUT3), CMD.15 (DIG_IN/OUT3), DMD.15 (DIG_IN/OUT3), MAIN_CONN_A.2, MAIN_CONN_B.2, MAIN_CONN_C.2, MAIN_CONN_D.2
unnamed: LED8.3 (DOUT), LED9.2 (DIN)
unnamed: LED10.3 (DOUT), LED11.2 (DIN)
unnamed: LED11.3 (DOUT), LED12.2 (DIN)
unnamed: LED9.3 (DOUT), LED10.2 (DIN)
unnamed: LED12.3 (DOUT), LED13.2 (DIN)
unnamed: LED13.3 (DOUT), LED14.2 (DIN)
unnamed: LED14.3 (DOUT), LED15.2 (DIN)
unnamed: LED15.3 (DOUT), LED16.2 (DIN)
unnamed: LED16.3 (DOUT), LED17.2 (DIN)
unnamed: LED17.3 (DOUT), LED18.2 (DIN)
unnamed: LED18.3 (DOUT), LED19.2 (DIN)
unnamed: LED19.3 (DOUT), LED20.2 (DIN)
unnamed: LED20.3 (DOUT), LED21.2 (DIN)
unnamed: LED21.3 (DOUT), LED22.2 (DIN)
unnamed: LED22.3 (DOUT), LED23.2 (DIN)
unnamed: LED23.3 (DOUT), LED24.2 (DIN)
unnamed: LED24.3 (DOUT), LED25.2 (DIN)
unnamed: LED25.3 (DOUT), LED26.2 (DIN)
unnamed: LED26.3 (DOUT), LED27.2 (DIN)
unnamed: LED27.3 (DOUT), LED28.2 (DIN)
unnamed: LED28.3 (DOUT), LED29.2 (DIN)
unnamed: LED29.3 (DOUT), LED30.2 (DIN)
unnamed: LED30.3 (DOUT), LED31.2 (DIN)
unnamed: LED0.3 (DOUT), LED1.2 (DIN)
unnamed: LED1.3 (DOUT), LED2.2 (DIN)
unnamed: LED2.3 (DOUT), LED3.2 (DIN)
unnamed: LED3.3 (DOUT), LED4.2 (DIN)
unnamed: LED4.3 (DOUT), LED5.2 (DIN)
unnamed: LED5.3 (DOUT), LED6.2 (DIN)
unnamed: LED6.3 (DOUT), LED7.2 (DIN)
unnamed: LED7.3 (DOUT), LED8.2 (DIN)
unnamed: D1.C, KICKER_R_CONN.P, QR.S
unnamed: D2.C, KICKER_F_CONN.P, QF.S
unnamed: QF.G, R49.1
unnamed: LED40.3 (DOUT), LED41.2 (DIN)
unnamed: LED41.3 (DOUT), LED42.2 (DIN)
unnamed: LED42.3 (DOUT), LED43.2 (DIN)
unnamed: LED43.3 (DOUT), LED44.2 (DIN)
unnamed: LED44.3 (DOUT), LED45.2 (DIN)
unnamed: LED45.3 (DOUT), LED46.2 (DIN)
unnamed: LED46.3 (DOUT), LED47.2 (DIN)
unnamed: MOSDRIVER.7 (OUT_1), R48.2
unnamed: LED32.3 (DOUT), LED33.2 (DIN)
unnamed: LED33.3 (DOUT), LED34.2 (DIN)
unnamed: LED34.3 (DOUT), LED35.2 (DIN)
unnamed: LED35.3 (DOUT), LED36.2 (DIN)
unnamed: LED36.3 (DOUT), LED37.2 (DIN)
unnamed: LED37.3 (DOUT), LED38.2 (DIN)
unnamed: LED38.3 (DOUT), LED39.2 (DIN)
unnamed: LED39.3 (DOUT), LED40.2 (DIN)
unnamed: MOSDRIVER.5 (OUT_2), R49.2
unnamed: AMD.19 (AN_OUT2), AOUT2.1
unnamed: QR.G, R48.1
unnamed: BMD.19 (AN_OUT2), BOUT2.1
unnamed: CMD.19 (AN_OUT2), COUT2.1
unnamed: DMD.19 (AN_OUT2), DOUT2.1
X_LINE0: PHOTO32.2, R32.1, XMUX.9 (I0)
X_LINE1: PHOTO33.2, R33.1, XMUX.8 (I1)
X_LINE2: PHOTO34.2, R34.1, XMUX.7 (I2)
X_LINE3: PHOTO35.2, R35.1, XMUX.6 (I3)
X_LINE4: PHOTO36.2, R36.1, XMUX.5 (I4)
X_LINE5: PHOTO37.2, R37.1, XMUX.4 (I5)
X_LINE6: PHOTO38.2, R38.1, XMUX.3 (I6)
X_LINE7: PHOTO39.2, R39.1, XMUX.2 (I7)
X_LINE8: PHOTO40.2, R40.1, XMUX.23 (I8)
X_LINE9: PHOTO41.2, R41.1, XMUX.22 (I9)
X_LINE10: PHOTO42.2, R42.1, XMUX.21 (I10)
X_LINE11: PHOTO43.2, R43.1, XMUX.20 (I11)
X_LINE12: PHOTO44.2, R44.1, XMUX.19 (I12)
X_LINE13: PHOTO45.2, R45.1, XMUX.18 (I13)
X_LINE14: PHOTO46.2, R46.1, XMUX.17 (I14)
X_LINE15: PHOTO47.2, R47.1, XMUX.16 (I15)

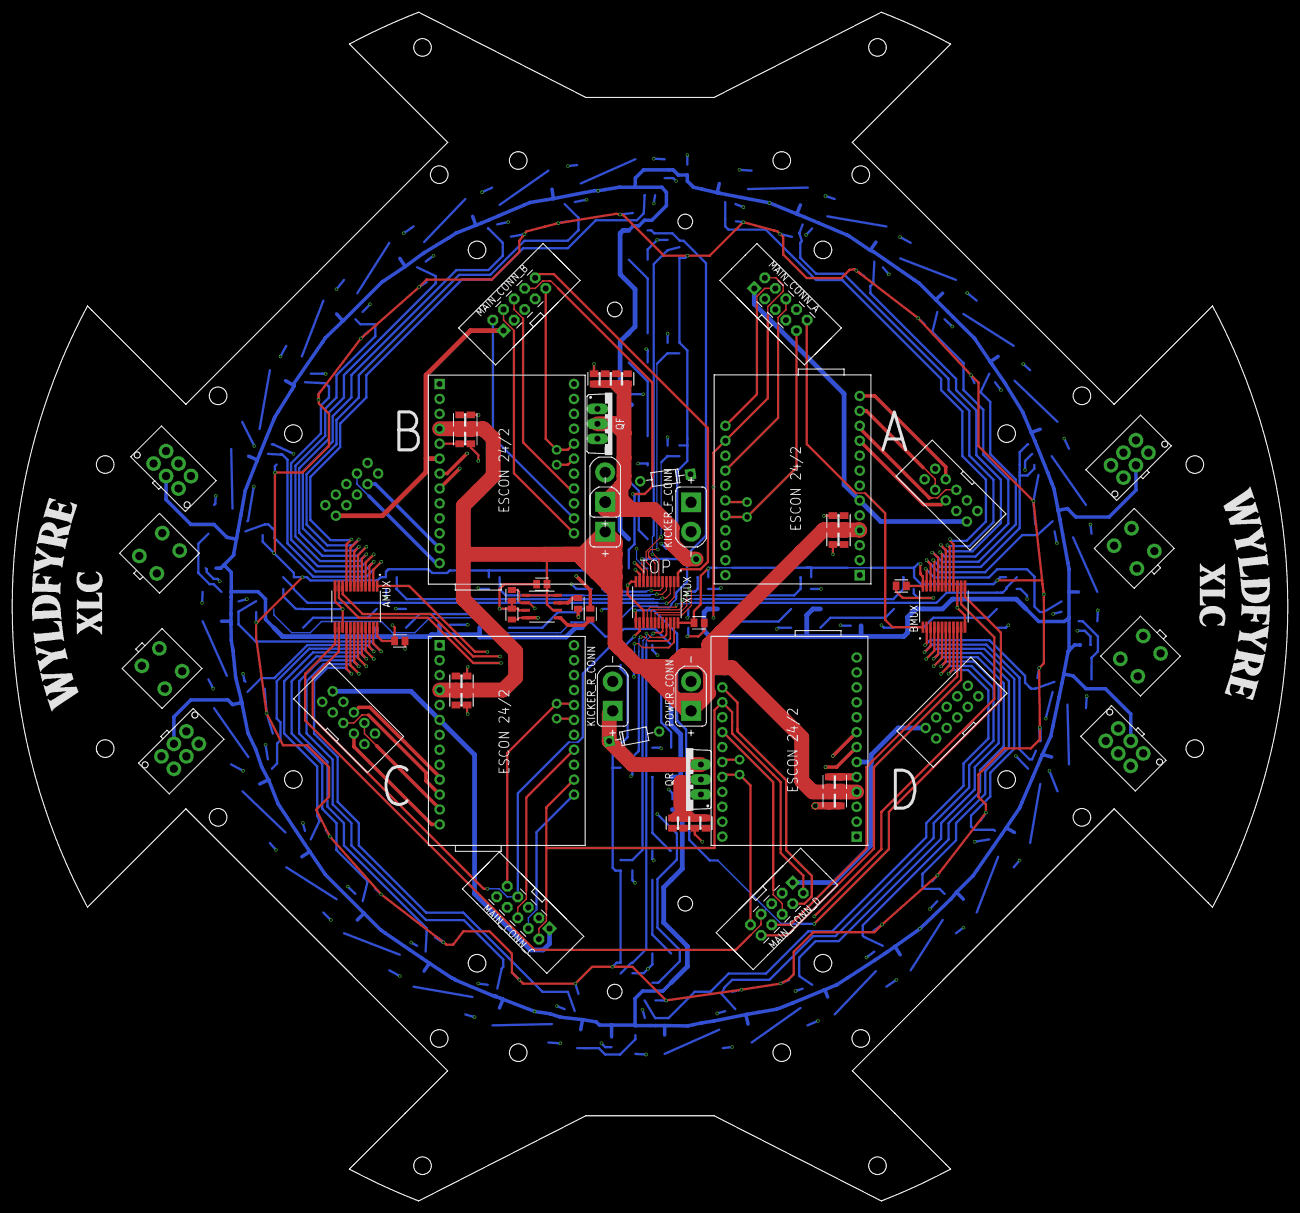
[picture p6: board Bottom_PCB.brd from above]

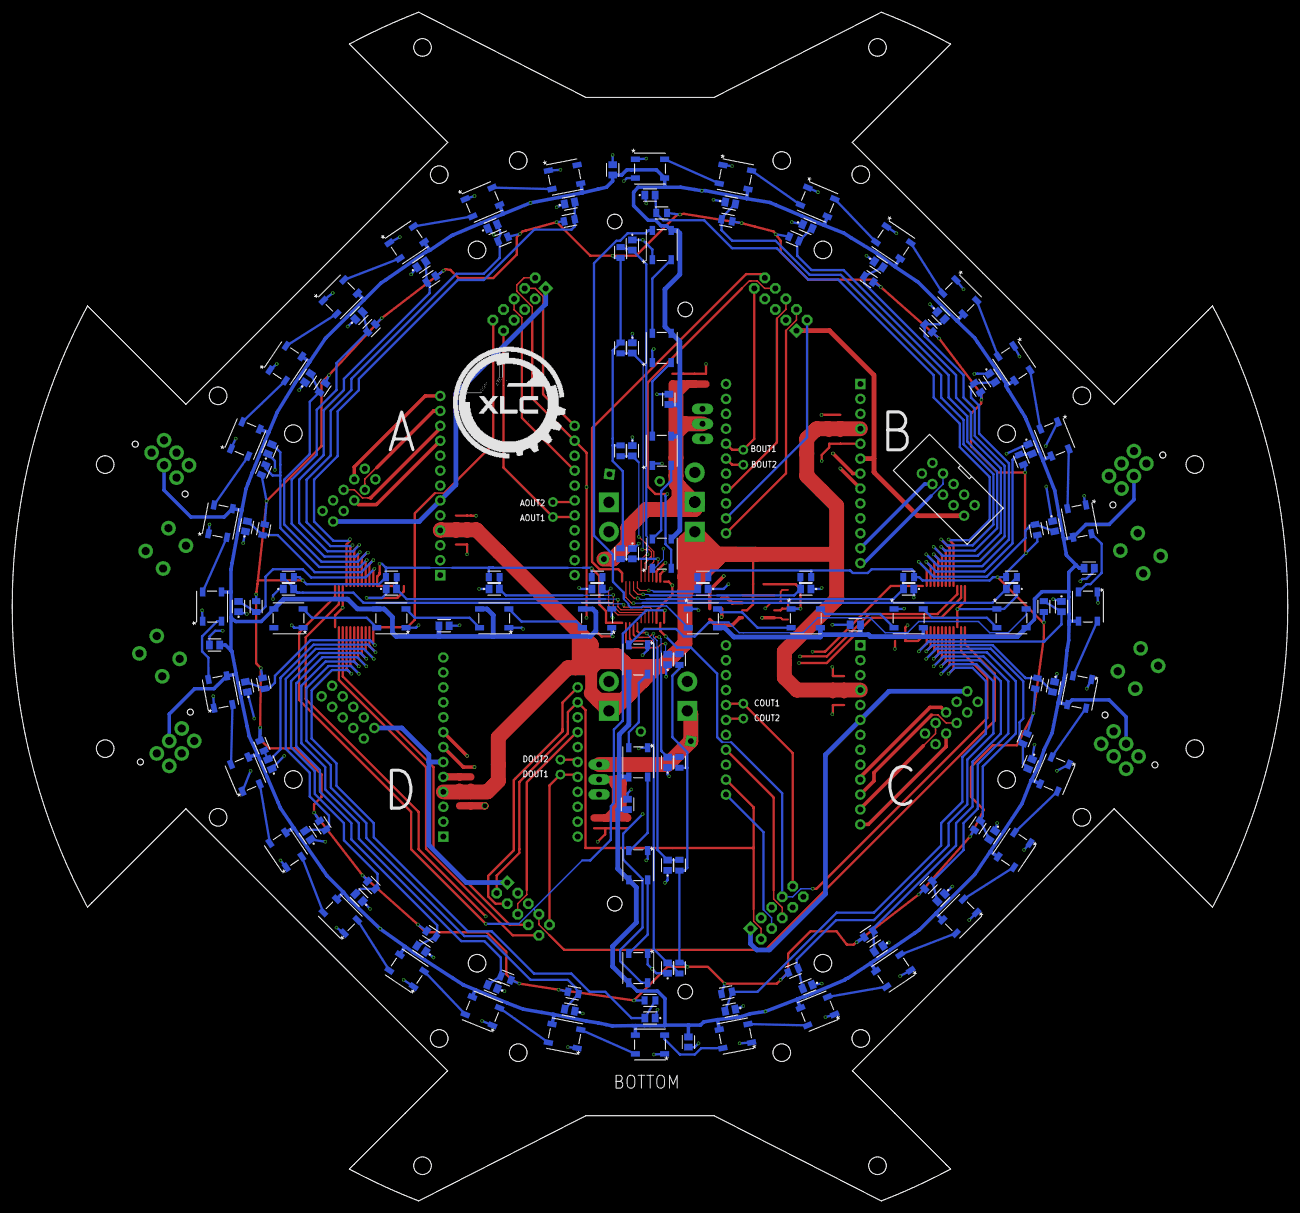
[picture p7: board Bottom_PCB.brd from below]

Board: 4 copper layers, 217.0 x 202.2 mm, 225 parts (161 on the bottom side), 173 nets.
