XLC-WyldFyre/Robocup-Junior-2026/Code/src/High/Services/motion_angles.cpp

#include "High/Services/motion_angles.h"

const float motionAngles[361][4] = {
  { 0.353555, 0.353552, -0.353555, -0.353552 },
  { 0.347331, 0.359669, -0.347331, -0.359669 },
  { 0.341001, 0.365675, -0.341001, -0.365675 },
  { 0.334567, 0.371571, -0.334567, -0.371571 },
  { 0.328031, 0.377353, -0.328031, -0.377353 },
  { 0.321395, 0.383021, -0.321395, -0.383021 },
  { 0.314662, 0.388572, -0.314662, -0.388572 },
  { 0.307832, 0.394004, -0.307832, -0.394004 },
  { 0.300909, 0.399317, -0.300909, -0.399317 },
  { 0.293894, 0.404507, -0.293894, -0.404507 },
  { 0.28679, 0.409575, -0.28679, -0.409575 },
  { 0.279598, 0.414518, -0.279598, -0.414518 },
  { 0.272321, 0.419334, -0.272321, -0.419334 },
  { 0.264961, 0.424023, -0.264961, -0.424023 },
  { 0.257521, 0.428583, -0.257521, -0.428583 },
  { 0.250002, 0.433012, -0.250002, -0.433012 },
  { 0.242407, 0.437309, -0.242407, -0.437309 },
  { 0.234738, 0.441473, -0.234738, -0.441473 },
  { 0.226997, 0.445502, -0.226997, -0.445502 },
  { 0.219187, 0.449396, -0.219187, -0.449396 },
  { 0.211311, 0.453153, -0.211311, -0.453153 },
  { 0.20337, 0.456772, -0.20337, -0.456772 },
  { 0.195368, 0.460252, -0.195368, -0.460252 },
  { 0.187305, 0.463591, -0.187305, -0.463591 },
  { 0.179186, 0.466789, -0.179186, -0.466789 },
  { 0.171012, 0.469846, -0.171012, -0.469846 },
  { 0.162786, 0.472759, -0.162786, -0.472759 },
  { 0.154511, 0.475528, -0.154511, -0.475528 },
  { 0.146188, 0.478152, -0.146188, -0.478152 },
  { 0.137821, 0.48063, -0.137821, -0.48063 },
  { 0.129412, 0.482962, -0.129412, -0.482962 },
  { 0.120963, 0.485147, -0.120963, -0.485147 },
  { 0.112478, 0.487185, -0.112478, -0.487185 },
  { 0.103958, 0.489073, -0.103958, -0.489073 },
  { 0.0954067, 0.490813, -0.0954067, -0.490813 },
  { 0.0868263, 0.492403, -0.0868263, -0.492403 },
  { 0.0782195, 0.493844, -0.0782195, -0.493844 },
  { 0.0695888, 0.495134, -0.0695888, -0.495134 },
  { 0.0609369, 0.496273, -0.0609369, -0.496273 },
  { 0.0522665, 0.497261, -0.0522665, -0.497261 },
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
};
