XLC-WyldFyre/Robocup-Junior-2026/Code/src/High/Modes/mode_controller.cpp

#include "High/Modes/mode_controller.h"
#include "High/Roles/role_attacker.h"
#include "High/Roles/role_controller.h"
#include "Low/Outputs/output_display.h"
#include "Low/Inputs/input_communication.h"
#include "Low/Inputs/input_ps5_controller.h"

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
            OUT::led_O.color = OUT::LedReduceBrightness(CRGB::Red, 1.0f);
            // OUT::led_O.color = CRGB::White;
            OUT::led_X.needsUpdate = true;
            OUT::led_X.color = OUT::LedReduceBrightness(CRGB::Red, 1.0f);
            // OUT::led_X.color = CRGB::White;

            OUT::led_Debug.needsUpdate = true;
            OUT::led_Debug.color[0] = CRGB::Black;
            OUT::led_Debug.color[1] = CRGB::Black;
            OUT::led_Debug.color[2] = CRGB::Black;
            OUT::led_Debug.color[3] = CRGB::Black;
        }

        if (IN::controller.connected != previouslyConnected) {
            _drawScreen_CONTROLLER();
        }


        OUT::motorAcc.motEn = true;
        input_controller_update();

        if(IN::controller.psButton.Click) {
            ST::controller.autoPlay = !ST::controller.autoPlay;
        }

        if(ST::controller.autoPlay) {
            if(ST::controller.previousAutoPlay != ST::controller.autoPlay) {
                ST::controller.previousAutoPlay = ST::controller.autoPlay;
                OUT::display.needsUpdate = true;
                display.drawBitmap(32, 0, image_controller_bits, 64, 64, 1);
                display.drawBitmap(3, 2, image_device_lock_bits, 13, 16, 1);
                display.drawBitmap(112, 47, image_device_key_retro_bits, 15, 16, 1);
            }
            Role::attacker();
        } else {
            if(ST::controller.previousAutoPlay != ST::controller.autoPlay) {
                ST::controller.previousAutoPlay = ST::controller.autoPlay;
                OUT::display.needsUpdate = true;
                display.drawBitmap(32, 0, image_controller_bits, 64, 64, 1);
            }
            Role::controller();  
        }
    } 
}
