XLC-WyldFyre/Robocup-Junior-2026/Code/src/High/Modes/mode_off.cpp

#include "High/Modes/mode_off.h"
#include "Low/Outputs/output_display.h"
#include "High/Services/motion.h"

namespace Images {
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
    display.print(IN::gyro.calMag);

    // Layer 3 copy 2
    display.setCursor(50, 50);
    display.print("A:");

    // Layer 4 copy 2
    display.setCursor(71, 50);
    display.print(IN::gyro.calAcl);

    // Layer 3 copy 3
    display.setCursor(93, 50);
    display.print("M:");

    // Layer 4 copy 3
    display.setCursor(114, 50);
    display.print(IN::gyro.calMag);

    // Layer 6 copy 1
    display.setCursor(53, 27);
    display.print(IN::gyro.offset);

    if(ST::state.isRobot_A) {
        // scorpion
        display.drawBitmap(7, 3, Images::image_scorpion_bits, 48, 48, 1);
    } else {
        // crocodile
        display.drawBitmap(1, 3, Images::image_crocodile_bits, 48, 48, 1);
    }

    if(IN::comms.onlineSoccer) {
        // hand_peace_sign
        display.drawBitmap(5, 3, Images::image_hand_peace_sign_bits, 11, 16, 1);
    } else {
        // network_www
        display.drawBitmap(3, 3, Images::image_network_www_bits, 16, 16, 1);
    }

    display.setTextSize(1);
    display.setCursor(2, 22);
    if(ST::soccer.defaultRole == ST::Types::role_t::Attacker) {
        display.print("A");
    } else if(ST::soccer.defaultRole == ST::Types::role_t::Defender) {
        display.print("D");
    } else if(ST::soccer.defaultRole == ST::Types::role_t::Test) {
        display.print("T");
    }
}


static void _drawScreen_1() {

    display.setTextSize(1);
    display.setTextColor(1);
    display.setTextWrap(false);

    display.setCursor(4, 4);
    display.print("Goal:");
    display.setCursor(34, 4);
    if (ST::soccer.enemyGoal == ST::Types::goal_t::Yellow) { display.print("Yellow"); }
    else { display.print("Blue"); }
    
    display.setCursor(4, 16);
    display.print("Robot:");
    display.setCursor(40, 16);
    if(ST::state.isRobot_A) { display.print("Scorpion"); }
    else { display.print("Crocodile"); }
    
    display.setCursor(4, 28);
    display.print("Mode:");
    display.setCursor(35, 28);
    if(ST::soccer.defaultRole == ST::Types::role_t::Attacker) { display.print("Attacker"); }
    else { display.print("Defender"); }
    
    display.setCursor(4, 41);
    display.print("LedCal();");

    display.setCursor(4, 53);
    display.print("KickTest();");


    switch(ST::offMenu.cursor) {
        case 0: display.drawBitmap(110, 3, Images::cursor_pointer, 6, 10, 1);
            break;
        case 1: display.drawBitmap(110, 15, Images::cursor_pointer, 6, 10, 1);
            break;
        case 2: display.drawBitmap(110, 27, Images::cursor_pointer, 6, 10, 1);
            break;
        case 3: display.drawBitmap(110, 39, Images::cursor_pointer, 6, 10, 1);
            break;
        case 4: display.drawBitmap(110, 51, Images::cursor_pointer, 6, 10, 1);
            break;
        default:
            break;
    }
}

void mode_off_begin() {
    Motion::dribler(0);
    // OUT::led_Debug.color[0] = CRGB::Black;
    // OUT::led_Debug.color[1] = CRGB::Black;
    // OUT::led_Debug.color[2] = CRGB::Black;
    // OUT::led_Debug.color[3] = CRGB::Black;
    // OUT::led_Debug.needsUpdate = true;
    OUT::led_O.color = CRGB::Black;
    OUT::led_O.needsUpdate = true;
    OUT::led_X.color = CRGB::Black;
    OUT::led_X.needsUpdate = true;
    OUT::motorAcc.motEn = false;
}


namespace Mode {

    void off() {
        if(ST::state.mode_previous != ST::Types::mode_t::Off) { mode_off_begin();}
        
        OUT::display.needsUpdate = true;

        if(ST::offMenu.screen == ST::Types::screen_t::Main) {
            _drawScreen_0();
        } else if (ST::offMenu.screen == ST::Types::screen_t::Settings) {
            _drawScreen_1();
        }
    } 
}
