XLC-WyldFyre/Robocup-Junior-2026/Code/src/Low/Inputs/input_gyro.cpp

#include "Low/Inputs/input_gyro.h"
#include "Adafruit_BNO055.h"
#include "Low/config_hw.h"

static Adafruit_BNO055 gyro = Adafruit_BNO055(HW::GyroCfg::GYRO_ID, HW::GyroCfg::GYRO_ADR, &Wire);
static float baseOffset = 0.0f;

void input_gyro_init_() {
    if (!gyro.begin(adafruit_bno055_opmode_t::OPERATION_MODE_IMUPLUS)) {
        return;
    }
    gyro.setExtCrystalUse(true);
}

static void _input_gyro_normalize() {
        if(IN::gyro.offset > 180.0f) {IN::gyro.offset -= 360.0f;}
        if(IN::gyro.offset < -180.0f) {IN::gyro.offset += 360.0f;}

        IN::gyro.offset_ToNField = IN::gyro.offset + 360.0f;
        if(IN::gyro.offset_ToNField >= 360.0f) {IN::gyro.offset_ToNField -= 360.0f;}
    }



void input_gyro_calibrate() {
    baseOffset = IN::gyro.offset + baseOffset;

    _input_gyro_normalize();
}


void input_gyro_update(){
    sensors_event_t event;
    gyro.getEvent(&event);
    IN::gyro.offset = (float)event.orientation.x - baseOffset;
    // Serial.print(IN::gyro.offset);
    // Serial.print("    ");
    _input_gyro_normalize();

//Get callibration status
    if(ST::state.mode == ST::Types::mode_t::Off) {
        gyro.getCalibration(&IN::gyro.calSys, &IN::gyro.calGyr, &IN::gyro.calAcl, &IN::gyro.calMag);
    }
}
