XLC-WyldFyre/Robocup-Junior-2026/(notices)

Notices in the files:
parts and their libraries:
2025-12-23_15-34-03_Library: COPYRIGHT: Copyright (C) 2025 Ultra Librarian. All rights reserved.
2026-02-10_19-56-46_Library: COPYRIGHT: Copyright (C) 2026 Ultra Librarian. All rights reserved.
